c3n3/house_led_cube/solid_works/cube_assem.SLDASM

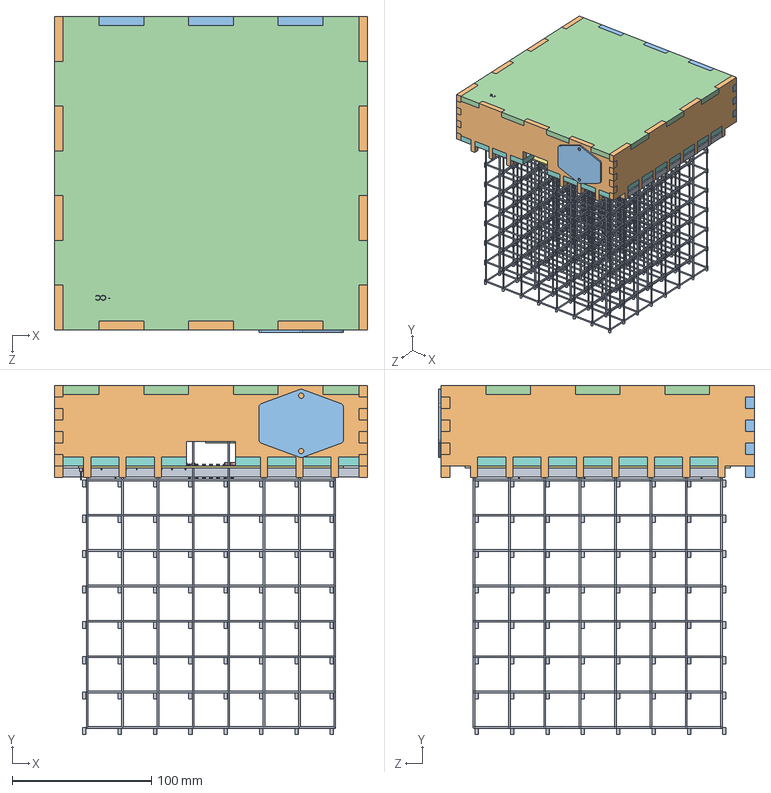
[picture p1: CAD file, 2020-12-22]
solid_works/cube_assem.SLDASM
225.0 x 250.6 x 226.9 mm
LED Cube
~side x 2
side_with_arduino
bottom
SOLID.step x 64
SOLID-0.step x 23
COMPOUND.step
holder x 2
cross_bar x 7
side
Switch
Power_Supply
