c3n3/house_led_cube/solid_works/bottom.SLDPRT

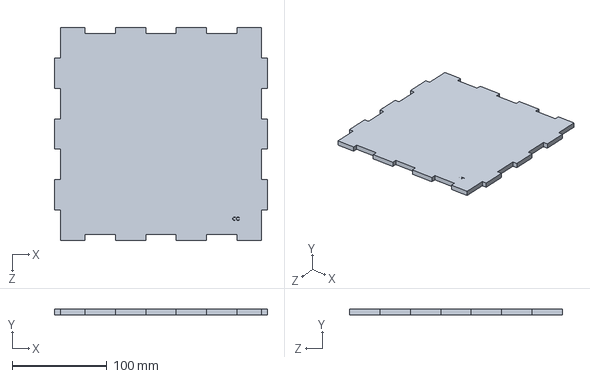
[picture p4: CAD file, 2020-12-22]
solid_works/bottom.SLDPRT
225.0 x 6.35 x 225.0 mm
