c3n3/house_led_cube/solid_works/holder.SLDPRT

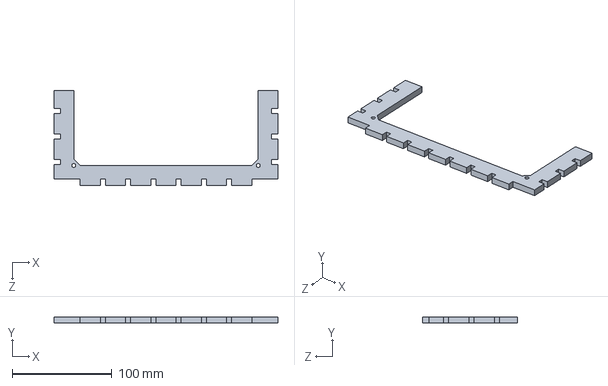
[picture p6: CAD file, 2020-12-22]
solid_works/holder.SLDPRT
225.0 x 6.35 x 95.0 mm
