c3n3/house_led_cube/solid_works/Switch.SLDPRT

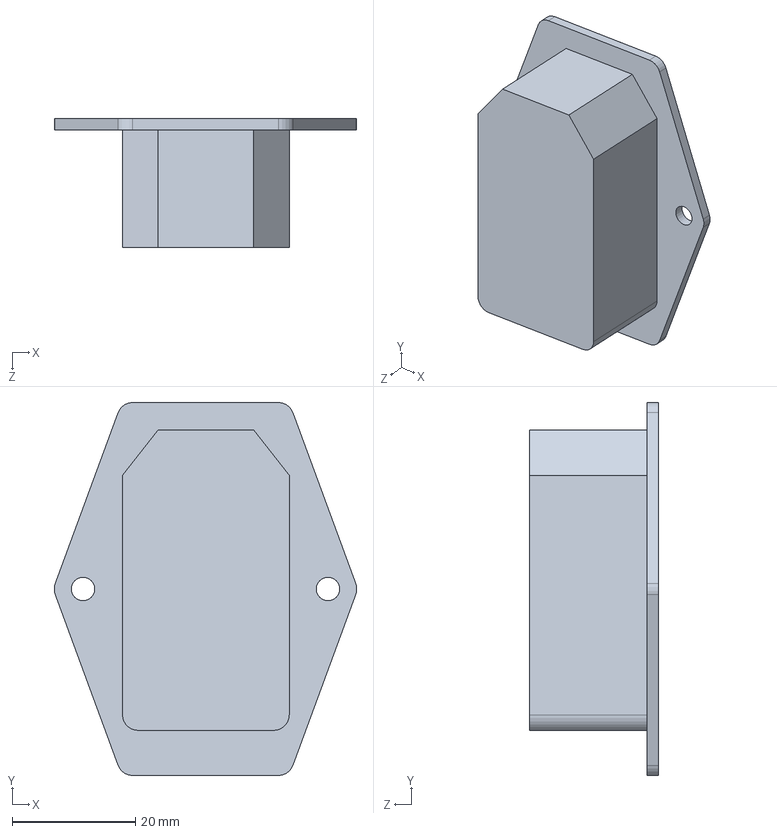
[picture p9: CAD file, 2020-12-22]
solid_works/Switch.SLDPRT
49.1 x 60.6 x 20.9 mm
