c3n3/house_led_cube/solid_works/laser_cube_base/bottom.DXF

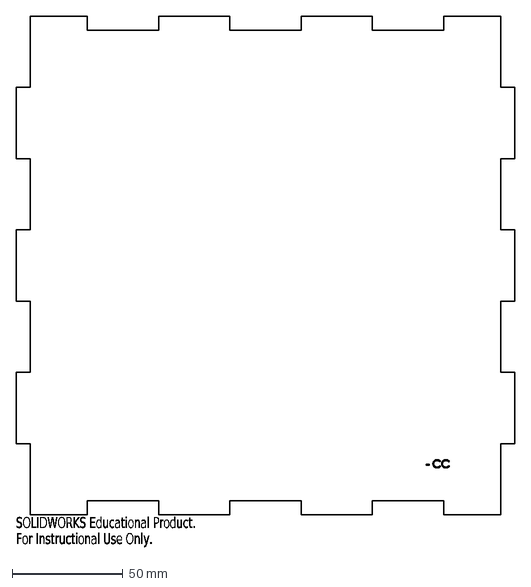
[picture p10: CAD file, 2020-12-22]
solid_works/laser_cube_base/bottom.DXF
SOLIDWORKS Educational Product.
For Instructional Use Only.
