c3n3/house_led_cube/solid_works/side_with_arduino.SLDPRT

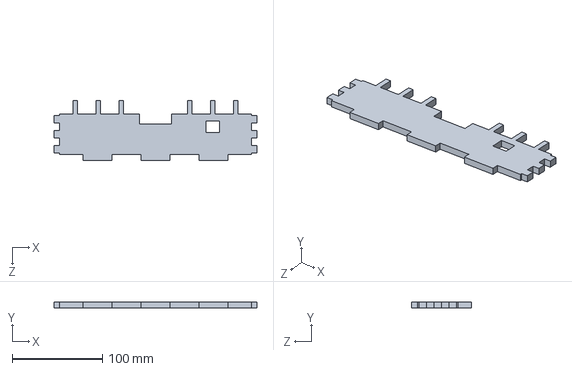
[picture p11: CAD file, 2020-12-22]
solid_works/side_with_arduino.SLDPRT
225.0 x 6.35 x 66.2 mm
