c3n3/house_led_cube/solid_works/led_cube_pcb.step

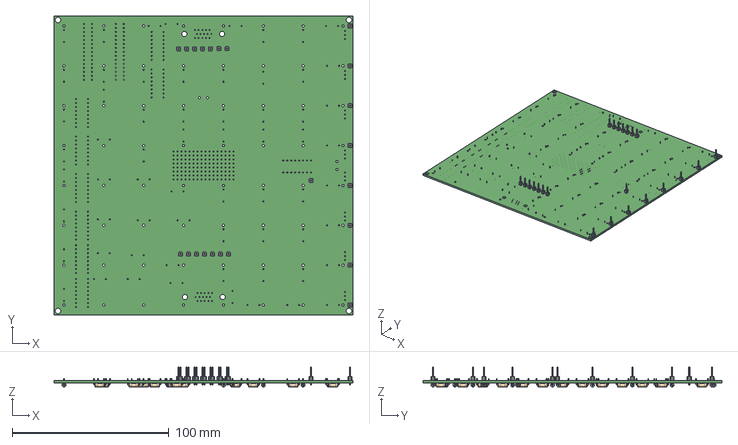
[picture p12: CAD file, 2020-12-08]
solid_works/led_cube_pcb.step
190.5 x 190.5 x 12.7 mm
