c3n3/house_led_cube/solid_works/cross_bar.SLDPRT

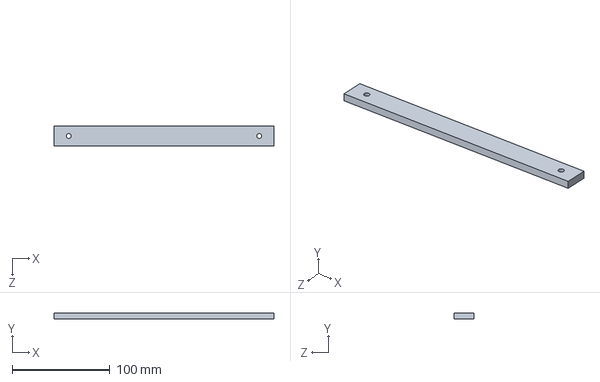
[picture p13: CAD file, 2020-12-08]
solid_works/cross_bar.SLDPRT
225.0 x 6.35 x 20.3 mm
