c3n3/house_led_cube/solid_works/pcb.SLDPRT

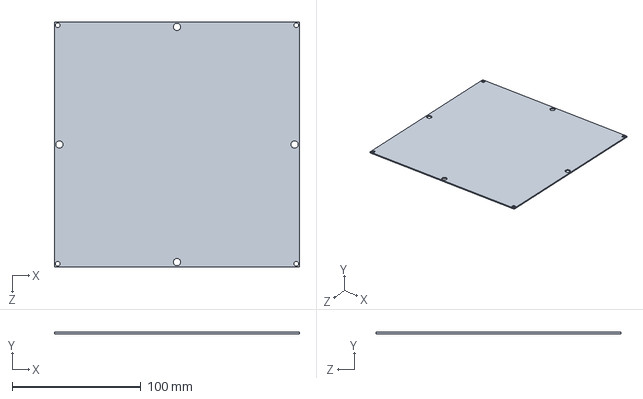
[picture p14: CAD file, 2020-12-03]
solid_works/pcb.SLDPRT
190.5 x 1.20 x 190.5 mm
