c3n3/house_led_cube/solid_works/led_array_4x8.SLDPRT

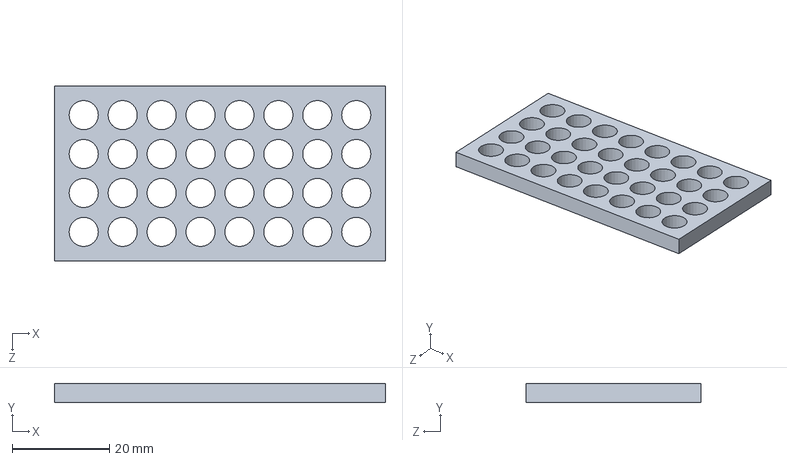
[picture p15: CAD file, 2020-09-20]
solid_works/led_array_4x8.SLDPRT
68.0 x 4.00 x 36.0 mm
