c3n3/house_led_cube/solid_works/Power_Supply.SLDPRT

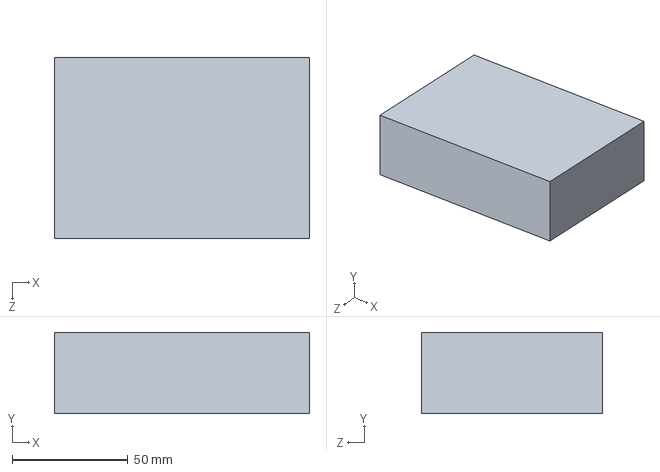
[picture p16: CAD file, 2020-09-08]
solid_works/Power_Supply.SLDPRT
110.0 x 35.0 x 78.0 mm
