c3n3/house_led_cube/solid_works/Base.SLDPRT

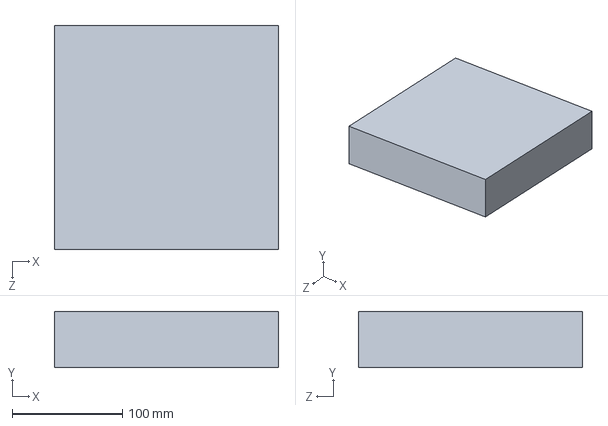
[picture p17: CAD file, 2020-09-08]
solid_works/Base.SLDPRT
203.2 x 50.8 x 203.2 mm
