c3n3/house_led_cube/(list of files, cad)

Other CAD files:
solid_works/box_temp.SLDPRT
solid_works/laser_cube_base/~side.DXF
solid_works/led_cube_pcb.SLDASM
solid_works/led_cube_pcb.SLDPRT
solid_works/~side.SLDPRT
