c3n3/house_led_cube/kicad/led_cube/controller/controller.kicad_pcb

## KiCad design kicad/led_cube/controller/controller.kicad_pcb (2020-12-22)

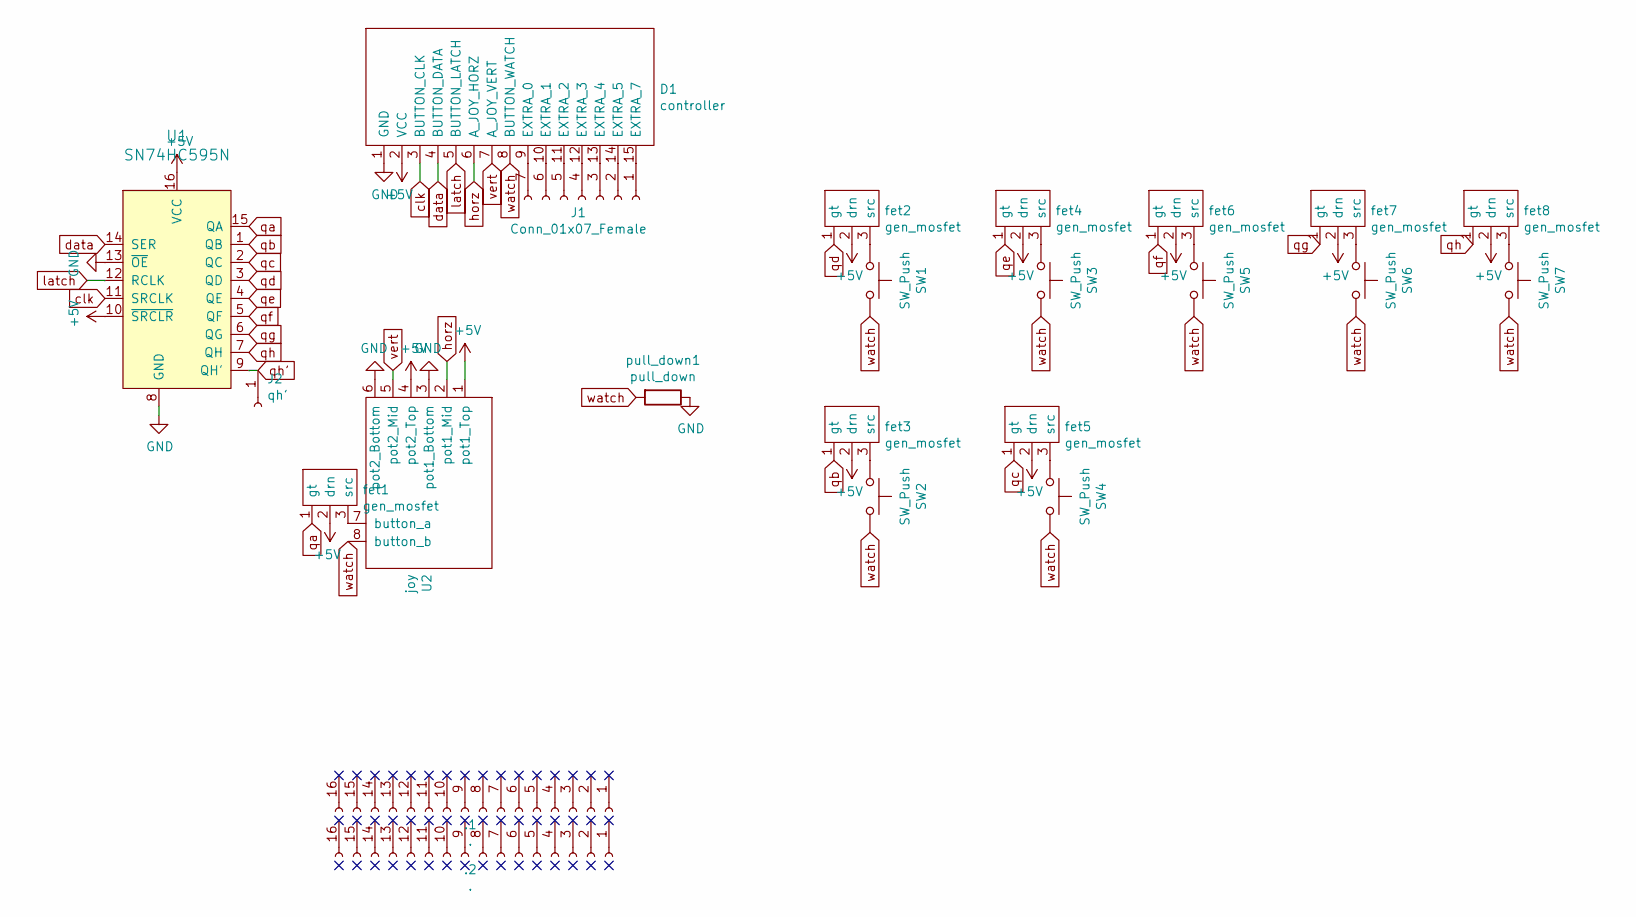
[picture p18: schematic controller.sch]

Parts:
.1, .2: .; proto
D1: controller; 15pin_controller
J1: Conn_01x07_Female; PinHeader_1x07_P2.54mm_Vertical
J2: qh'; PinHeader_1x01_P2.54mm_Horizontal
SW1, SW2, SW3, SW4, SW5, SW6, SW7: SW_Push; button
U1: SN74HC595N; MPN SN74HC595N; Digi-Key_PN 296-1600-5-ND
U2: joy
fet1, fet2, fet3, fet4, fet5, fet6, fet7, fet8: gen_mosfet; gen_fet
pull_down1: pull_down; R_Axial_DIN0207_L6.3mm_D2.5mm_P10.16mm_Horizontal

Connections:
+5V: D1.2 (VCC), U1.10 (~SRCLR), U1.16 (VCC), U2.1 (pot1_Top), U2.4 (pot2_Top), fet1.2 (drn), fet2.2 (drn), fet3.2 (drn), fet4.2 (drn), fet5.2 (drn), fet6.2 (drn), fet7.2 (drn), fet8.2 (drn)
GND: D1.1 (GND), U1.8 (GND), U1.13 (~OE), U2.3 (pot1_Bottom), U2.6 (pot2_Bottom), pull_down1.1
unnamed: D1.9 (EXTRA_0), J1.7
unnamed: D1.10 (EXTRA_1), J1.6
unnamed: D1.11 (EXTRA_2), J1.5
unnamed: D1.12 (EXTRA_3), J1.4
unnamed: D1.13 (EXTRA_4), J1.3
unnamed: D1.14 (EXTRA_5), J1.2
unnamed: D1.15 (EXTRA_7), J1.1
unnamed: SW1.1, fet2.3 (src)
unnamed: SW2.1, fet3.3 (src)
unnamed: SW3.1, fet4.3 (src)
unnamed: SW4.1, fet5.3 (src)
unnamed: SW5.1, fet6.3 (src)
unnamed: SW6.1, fet7.3 (src)
unnamed: SW7.1, fet8.3 (src)
unnamed: U2.7 (button_a), fet1.3 (src)
clk: D1.3 (BUTTON_CLK), U1.11 (SRCLK)
data: D1.4 (BUTTON_DATA), U1.14 (SER)
horz: D1.6 (A_JOY_HORZ), U2.2 (pot1_Mid)
latch: D1.5 (BUTTON_LATCH), U1.12 (RCLK)
qa: U1.15 (QA), fet1.1 (gt)
qb: U1.1 (QB), fet3.1 (gt)
qc: U1.2 (QC), fet5.1 (gt)
qd: U1.3 (QD), fet2.1 (gt)
qe: U1.4 (QE), fet4.1 (gt)
qf: U1.5 (QF), fet6.1 (gt)
qg: U1.6 (QG), fet7.1 (gt)
qh: U1.7 (QH), fet8.1 (gt)
qh': J2.1, U1.9 (QH')
vert: D1.7 (A_JOY_VERT), U2.5 (pot2_Mid)
watch: D1.8 (BUTTON_WATCH), SW1.2, SW2.2, SW3.2, SW4.2, SW5.2, SW6.2, SW7.2, U2.8 (button_b), pull_down1.2

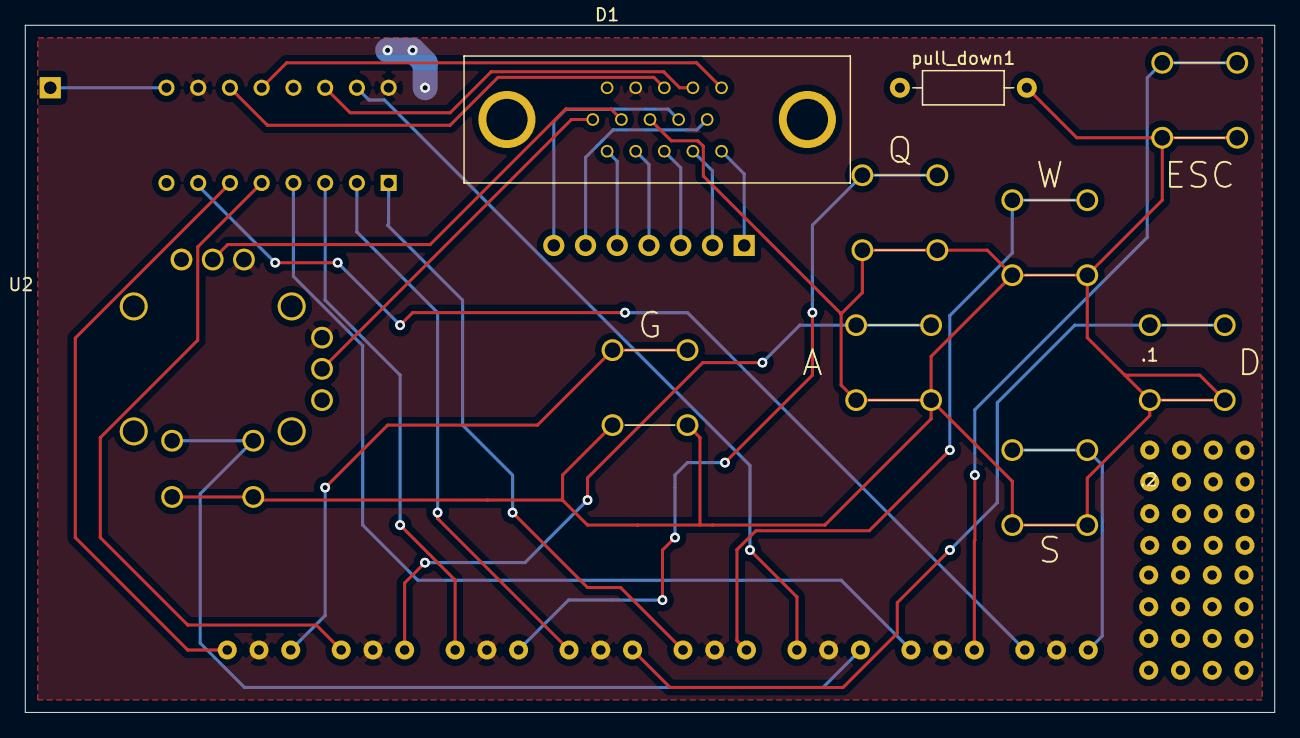
[picture p19: board controller.kicad_pcb from above]

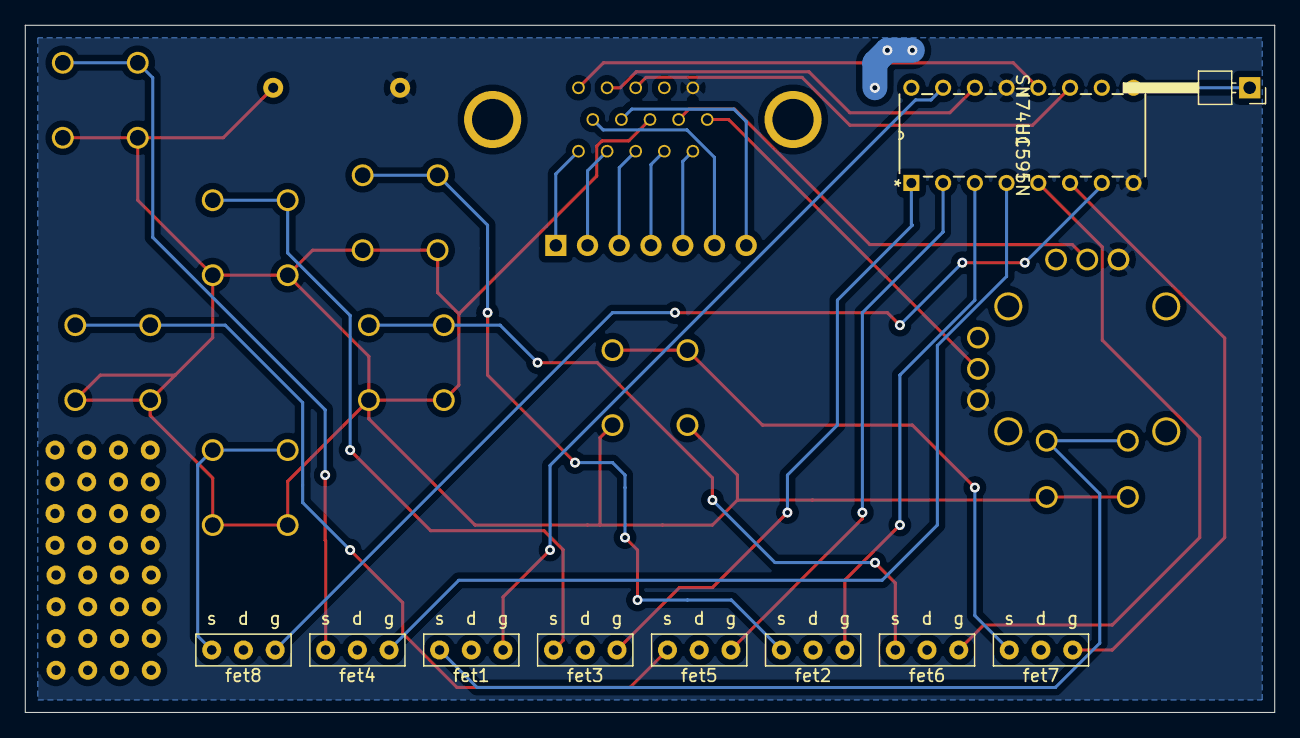
[picture p20: board controller.kicad_pcb from below]

Board: 2 copper layers, 100.0 x 55.0 mm, 23 parts (10 on the bottom side), 32 nets.
