c3n3/house_led_cube/kicad/led_cube/led_cube.kicad_pcb

## KiCad design kicad/led_cube/led_cube.kicad_pcb (2020-12-13)

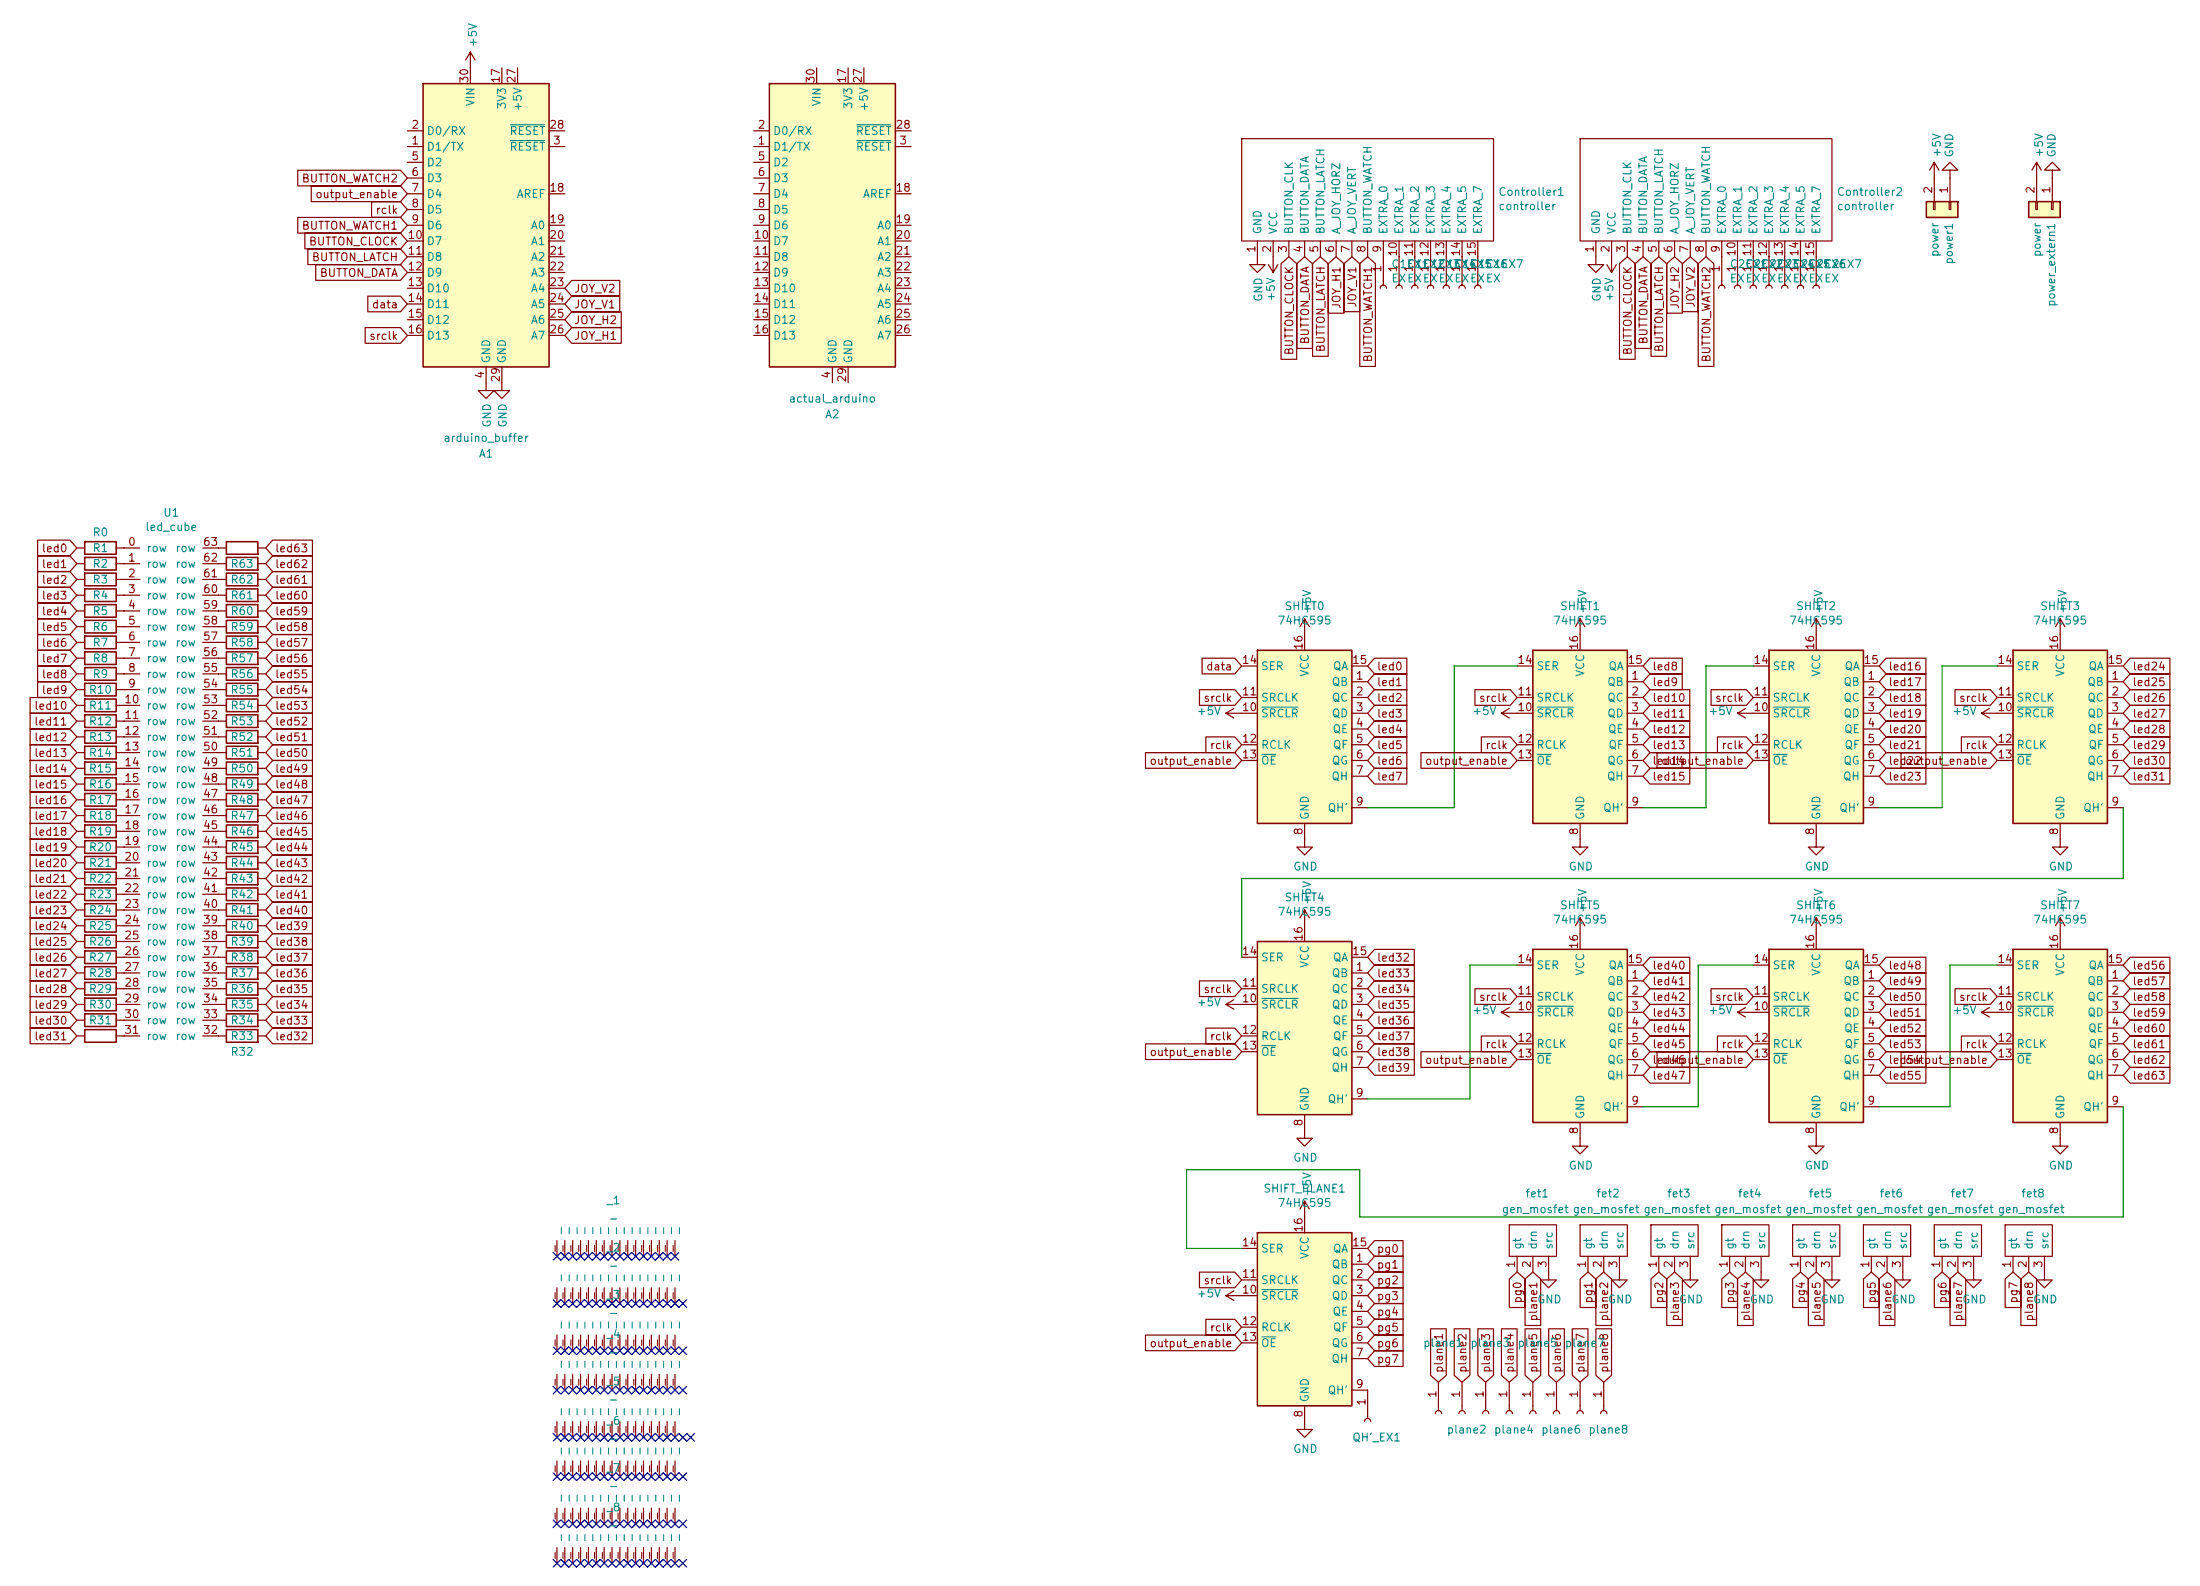
[picture p21: schematic led_cube.sch]

Parts:
A1: arduino_buffer; nano_buffer
A2: actual_arduino; nano
C1EX1, C1EX2, C1EX3, C1EX4, C1EX5, C1EX6, C1EX7, C2EX1, C2EX2, C2EX3, C2EX4, C2EX5, C2EX6, C2EX7: EX; PinHeader_1x01_P2.54mm_Vertical
Controller1, Controller2: controller; 15pin_controller
QH'_EX1: PinHeader_1x01_P2.54mm_Vertical
R0, R1, R2, R3, R4, R5, R6, R7, R8, R9, R10, R11, R12, R13, R14, R15, R16, R17, R18, R19, R20, R21, R22, R23, R24, R25, R26, R27, R28, R29, R30, R31, R32, R33, R34, R35, R36, R37, R38, R39, R40, R41, R42, R43, R44, R45, R46, R47, R48, R49, R50, R51, R52, R53, R54, R55, R56, R57, R58, R59, R60, R61, R62, R63: R_Axial_DIN0207_L6.3mm_D2.5mm_P7.62mm_Horizontal
SHIFT0, SHIFT1, SHIFT2, SHIFT3, SHIFT4, SHIFT5, SHIFT6, SHIFT7: 74HC595; SN74HC595N
SHIFT_PLANE1: 74HC595; SN74HC595N
U1: led_cube
_1, _2, _3, _4, _5, _6, _7, _8: _; proto
fet1, fet2, fet3, fet4, fet5, fet6, fet7, fet8: gen_mosfet; gen_fet
plane1, plane2, plane3, plane4, plane5, plane6, plane7, plane8: PinHeader_1x01_P2.54mm_Vertical
power1: power
power_extern1: power

Connections:
+5V: A1.30 (VIN), Controller1.2 (VCC), Controller2.2 (VCC), SHIFT0.10 (~SRCLR), SHIFT0.16 (VCC), SHIFT1.10 (~SRCLR), SHIFT1.16 (VCC), SHIFT2.10 (~SRCLR), SHIFT2.16 (VCC), SHIFT3.10 (~SRCLR), SHIFT3.16 (VCC), SHIFT4.10 (~SRCLR), SHIFT4.16 (VCC), SHIFT5.10 (~SRCLR), SHIFT5.16 (VCC), SHIFT6.10 (~SRCLR), SHIFT6.16 (VCC), SHIFT7.10 (~SRCLR), SHIFT7.16 (VCC), SHIFT_PLANE1.10 (~SRCLR), SHIFT_PLANE1.16 (VCC), power1.2, power_extern1.2
BUTTON_CLOCK: A1.10 (D7), Controller1.3 (BUTTON_CLK), Controller2.3 (BUTTON_CLK)
BUTTON_DATA: A1.12 (D9), Controller1.4 (BUTTON_DATA), Controller2.4 (BUTTON_DATA)
BUTTON_LATCH: A1.11 (D8), Controller1.5 (BUTTON_LATCH), Controller2.5 (BUTTON_LATCH)
BUTTON_WATCH1: A1.9 (D6), Controller1.8 (BUTTON_WATCH)
BUTTON_WATCH2: A1.6 (D3), Controller2.8 (BUTTON_WATCH)
GND: A1.4 (GND), A1.29 (GND), Controller1.1 (GND), Controller2.1 (GND), SHIFT0.8 (GND), SHIFT1.8 (GND), SHIFT2.8 (GND), SHIFT3.8 (GND), SHIFT4.8 (GND), SHIFT5.8 (GND), SHIFT6.8 (GND), SHIFT7.8 (GND), SHIFT_PLANE1.8 (GND), fet1.3 (src), fet2.3 (src), fet3.3 (src), fet4.3 (src), fet5.3 (src), fet6.3 (src), fet7.3 (src), fet8.3 (src), power1.1, power_extern1.1
JOY_H1: A1.26 (A7), Controller1.6 (A_JOY_HORZ)
JOY_H2: A1.25 (A6), Controller2.6 (A_JOY_HORZ)
JOY_V1: A1.24 (A5), Controller1.7 (A_JOY_VERT)
JOY_V2: A1.23 (A4), Controller2.7 (A_JOY_VERT)
unnamed: C1EX1.1, Controller1.9 (EXTRA_0)
unnamed: C1EX2.1, Controller1.10 (EXTRA_1)
unnamed: C1EX3.1, Controller1.11 (EXTRA_2)
unnamed: C1EX4.1, Controller1.12 (EXTRA_3)
unnamed: C1EX5.1, Controller1.13 (EXTRA_4)
unnamed: C1EX6.1, Controller1.14 (EXTRA_5)
unnamed: C1EX7.1, Controller1.15 (EXTRA_7)
unnamed: C2EX1.1, Controller2.9 (EXTRA_0)
unnamed: C2EX2.1, Controller2.10 (EXTRA_1)
unnamed: C2EX3.1, Controller2.11 (EXTRA_2)
unnamed: C2EX4.1, Controller2.12 (EXTRA_3)
unnamed: C2EX5.1, Controller2.13 (EXTRA_4)
unnamed: C2EX6.1, Controller2.14 (EXTRA_5)
unnamed: C2EX7.1, Controller2.15 (EXTRA_7)
unnamed: QH'_EX1.1, SHIFT_PLANE1.9 (QH')
unnamed: R0.1, U1.0
unnamed: R1.1, U1.1
unnamed: R2.1, U1.2
unnamed: R3.1, U1.3
unnamed: R4.1, U1.4
unnamed: R5.1, U1.5
unnamed: R6.1, U1.6
unnamed: R7.1, U1.7
unnamed: R8.1, U1.8
unnamed: R9.1, U1.9
unnamed: R10.1, U1.10
unnamed: R11.1, U1.11
unnamed: R12.1, U1.12
unnamed: R13.1, U1.13
unnamed: R14.1, U1.14
unnamed: R15.1, U1.15
unnamed: R16.1, U1.16
unnamed: R17.1, U1.17
unnamed: R18.1, U1.18
unnamed: R19.1, U1.19
unnamed: R20.1, U1.20
unnamed: R21.1, U1.21
unnamed: R22.1, U1.22
unnamed: R23.1, U1.23
unnamed: R24.1, U1.24
unnamed: R25.1, U1.25
unnamed: R26.1, U1.26
unnamed: R27.1, U1.27
unnamed: R28.1, U1.28
unnamed: R29.1, U1.29
unnamed: R30.1, U1.30
unnamed: R31.1, U1.31
unnamed: R32.1, U1.32
unnamed: R33.1, U1.33
unnamed: R34.1, U1.34
unnamed: R35.1, U1.35
unnamed: R36.1, U1.36
unnamed: R37.1, U1.37
unnamed: R38.1, U1.38
unnamed: R39.1, U1.39
unnamed: R40.1, U1.40
unnamed: R41.1, U1.41
unnamed: R42.1, U1.42
unnamed: R43.1, U1.43
unnamed: R44.1, U1.44
unnamed: R45.1, U1.45
unnamed: R46.1, U1.46
unnamed: R47.1, U1.47
unnamed: R48.1, U1.48
unnamed: R49.1, U1.49
unnamed: R50.1, U1.50
unnamed: R51.1, U1.51
unnamed: R52.1, U1.52
unnamed: R53.1, U1.53
unnamed: R54.1, U1.54
unnamed: R55.1, U1.55
unnamed: R56.1, U1.56
unnamed: R57.1, U1.57
unnamed: R58.1, U1.58
unnamed: R59.1, U1.59
unnamed: R60.1, U1.60
unnamed: R61.1, U1.61
unnamed: R62.1, U1.62
unnamed: R63.1, U1.63
unnamed: SHIFT0.9 (QH'), SHIFT1.14 (SER)
unnamed: SHIFT1.9 (QH'), SHIFT2.14 (SER)
unnamed: SHIFT2.9 (QH'), SHIFT3.14 (SER)
unnamed: SHIFT3.9 (QH'), SHIFT4.14 (SER)
unnamed: SHIFT4.9 (QH'), SHIFT5.14 (SER)
unnamed: SHIFT5.9 (QH'), SHIFT6.14 (SER)
unnamed: SHIFT6.9 (QH'), SHIFT7.14 (SER)
unnamed: SHIFT7.9 (QH'), SHIFT_PLANE1.14 (SER)
data: A1.14 (D11), SHIFT0.14 (SER)
led0: R0.2, SHIFT0.15 (QA)
led1: R1.2, SHIFT0.1 (QB)
led2: R2.2, SHIFT0.2 (QC)
led3: R3.2, SHIFT0.3 (QD)
led4: R4.2, SHIFT0.4 (QE)
led5: R5.2, SHIFT0.5 (QF)
led6: R6.2, SHIFT0.6 (QG)
led7: R7.2, SHIFT0.7 (QH)
led8: R8.2, SHIFT1.15 (QA)
led9: R9.2, SHIFT1.1 (QB)
led10: R10.2, SHIFT1.2 (QC)
led11: R11.2, SHIFT1.3 (QD)
led12: R12.2, SHIFT1.4 (QE)
led13: R13.2, SHIFT1.5 (QF)
led14: R14.2, SHIFT1.6 (QG)
led15: R15.2, SHIFT1.7 (QH)
led16: R16.2, SHIFT2.15 (QA)
led17: R17.2, SHIFT2.1 (QB)
led18: R18.2, SHIFT2.2 (QC)
led19: R19.2, SHIFT2.3 (QD)
led20: R20.2, SHIFT2.4 (QE)
led21: R21.2, SHIFT2.5 (QF)
led22: R22.2, SHIFT2.6 (QG)
led23: R23.2, SHIFT2.7 (QH)
led24: R24.2, SHIFT3.15 (QA)
led25: R25.2, SHIFT3.1 (QB)
led26: R26.2, SHIFT3.2 (QC)
led27: R27.2, SHIFT3.3 (QD)
led28: R28.2, SHIFT3.4 (QE)
led29: R29.2, SHIFT3.5 (QF)
led30: R30.2, SHIFT3.6 (QG)
led31: R31.2, SHIFT3.7 (QH)
led32: R32.2, SHIFT4.15 (QA)
led33: R33.2, SHIFT4.1 (QB)
led34: R34.2, SHIFT4.2 (QC)
led35: R35.2, SHIFT4.3 (QD)
led36: R36.2, SHIFT4.4 (QE)
led37: R37.2, SHIFT4.5 (QF)
led38: R38.2, SHIFT4.6 (QG)
led39: R39.2, SHIFT4.7 (QH)
led40: R40.2, SHIFT5.15 (QA)
led41: R41.2, SHIFT5.1 (QB)
led42: R42.2, SHIFT5.2 (QC)
led43: R43.2, SHIFT5.3 (QD)
led44: R44.2, SHIFT5.4 (QE)
led45: R45.2, SHIFT5.5 (QF)
led46: R46.2, SHIFT5.6 (QG)
led47: R47.2, SHIFT5.7 (QH)
led48: R48.2, SHIFT6.15 (QA)
led49: R49.2, SHIFT6.1 (QB)
led50: R50.2, SHIFT6.2 (QC)
led51: R51.2, SHIFT6.3 (QD)
led52: R52.2, SHIFT6.4 (QE)
led53: R53.2, SHIFT6.5 (QF)
led54: R54.2, SHIFT6.6 (QG)
led55: R55.2, SHIFT6.7 (QH)
led56: R56.2, SHIFT7.15 (QA)
led57: R57.2, SHIFT7.1 (QB)
led58: R58.2, SHIFT7.2 (QC)
led59: R59.2, SHIFT7.3 (QD)
led60: R60.2, SHIFT7.4 (QE)
led61: R61.2, SHIFT7.5 (QF)
led62: R62.2, SHIFT7.6 (QG)
led63: R63.2, SHIFT7.7 (QH)
output_enable: A1.7 (D4), SHIFT0.13 (~OE), SHIFT1.13 (~OE), SHIFT2.13 (~OE), SHIFT3.13 (~OE), SHIFT4.13 (~OE), SHIFT5.13 (~OE), SHIFT6.13 (~OE), SHIFT7.13 (~OE), SHIFT_PLANE1.13 (~OE)
pg0: SHIFT_PLANE1.15 (QA), fet1.1 (gt)
pg1: SHIFT_PLANE1.1 (QB), fet2.1 (gt)
pg2: SHIFT_PLANE1.2 (QC), fet3.1 (gt)
pg3: SHIFT_PLANE1.3 (QD), fet4.1 (gt)
pg4: SHIFT_PLANE1.4 (QE), fet5.1 (gt)
pg5: SHIFT_PLANE1.5 (QF), fet6.1 (gt)
pg6: SHIFT_PLANE1.6 (QG), fet7.1 (gt)
pg7: SHIFT_PLANE1.7 (QH), fet8.1 (gt)
plane1: fet1.2 (drn), plane1.1
plane2: fet2.2 (drn), plane2.1
plane3: fet3.2 (drn), plane3.1
plane4: fet4.2 (drn), plane4.1
plane5: fet5.2 (drn), plane5.1
plane6: fet6.2 (drn), plane6.1
plane7: fet7.2 (drn), plane7.1
plane8: fet8.2 (drn), plane8.1
rclk: A1.8 (D5), SHIFT0.12 (RCLK), SHIFT1.12 (RCLK), SHIFT2.12 (RCLK), SHIFT3.12 (RCLK), SHIFT4.12 (RCLK), SHIFT5.12 (RCLK), SHIFT6.12 (RCLK), SHIFT7.12 (RCLK), SHIFT_PLANE1.12 (RCLK)
srclk: A1.16 (D13), SHIFT0.11 (SRCLK), SHIFT1.11 (SRCLK), SHIFT2.11 (SRCLK), SHIFT3.11 (SRCLK), SHIFT4.11 (SRCLK), SHIFT5.11 (SRCLK), SHIFT6.11 (SRCLK), SHIFT7.11 (SRCLK), SHIFT_PLANE1.11 (SRCLK)

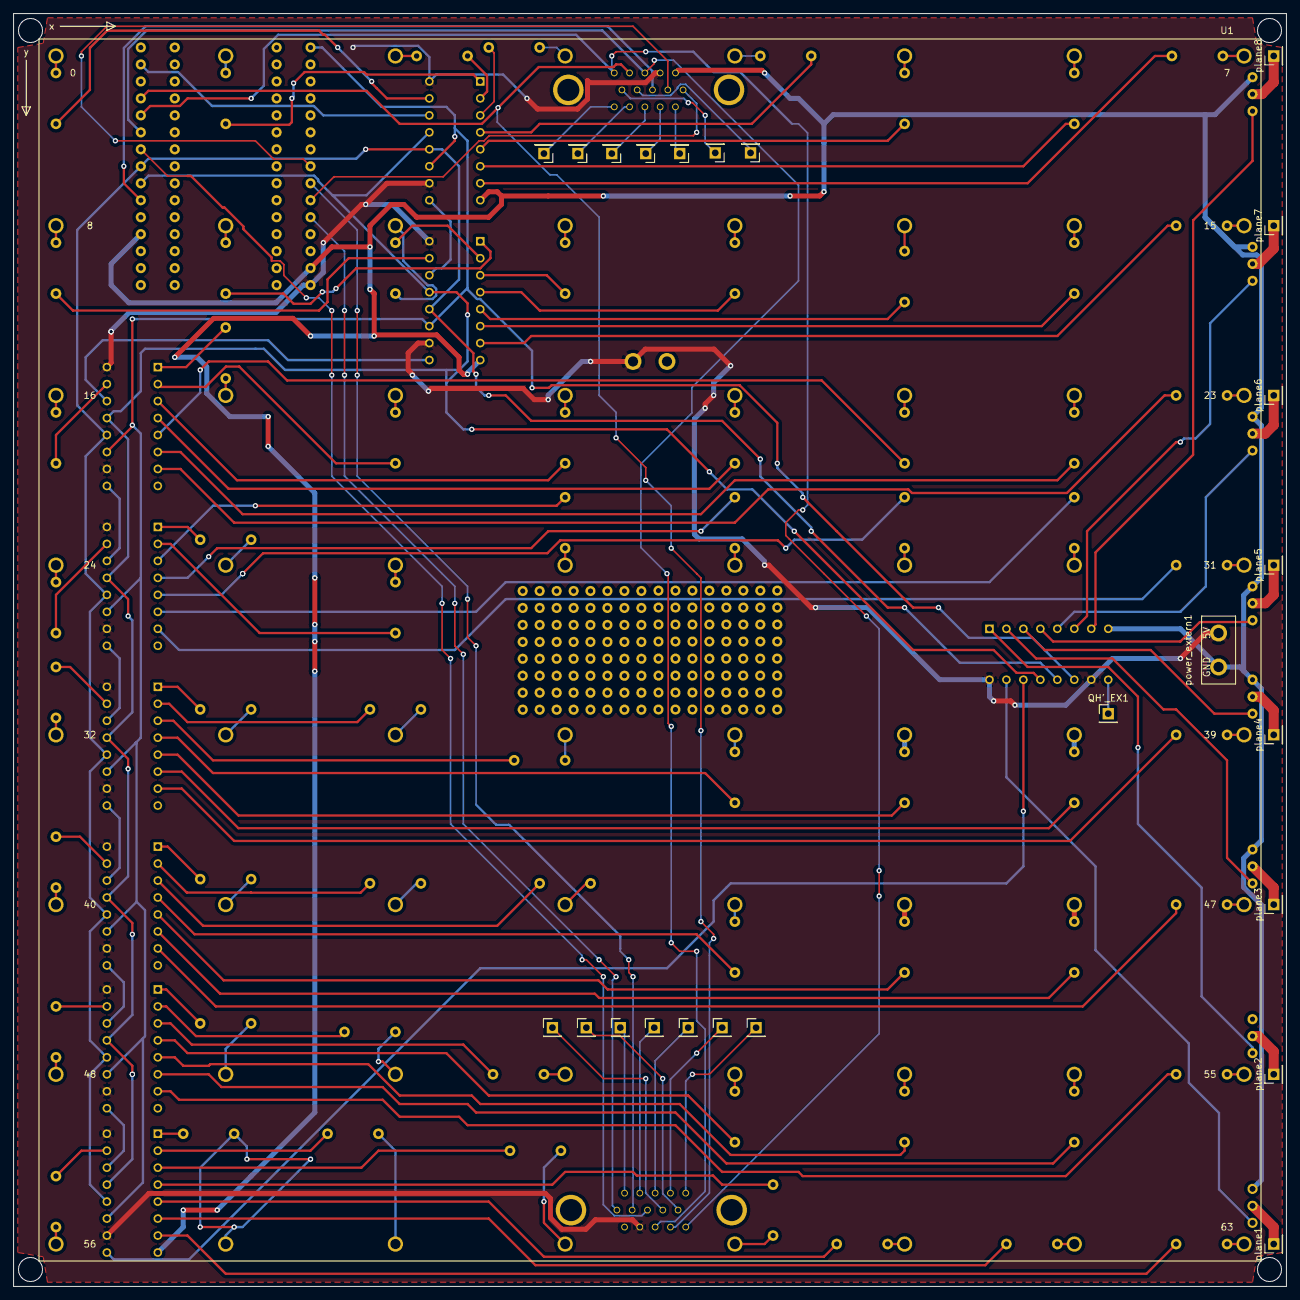
[picture p22: board led_cube.kicad_pcb from above]

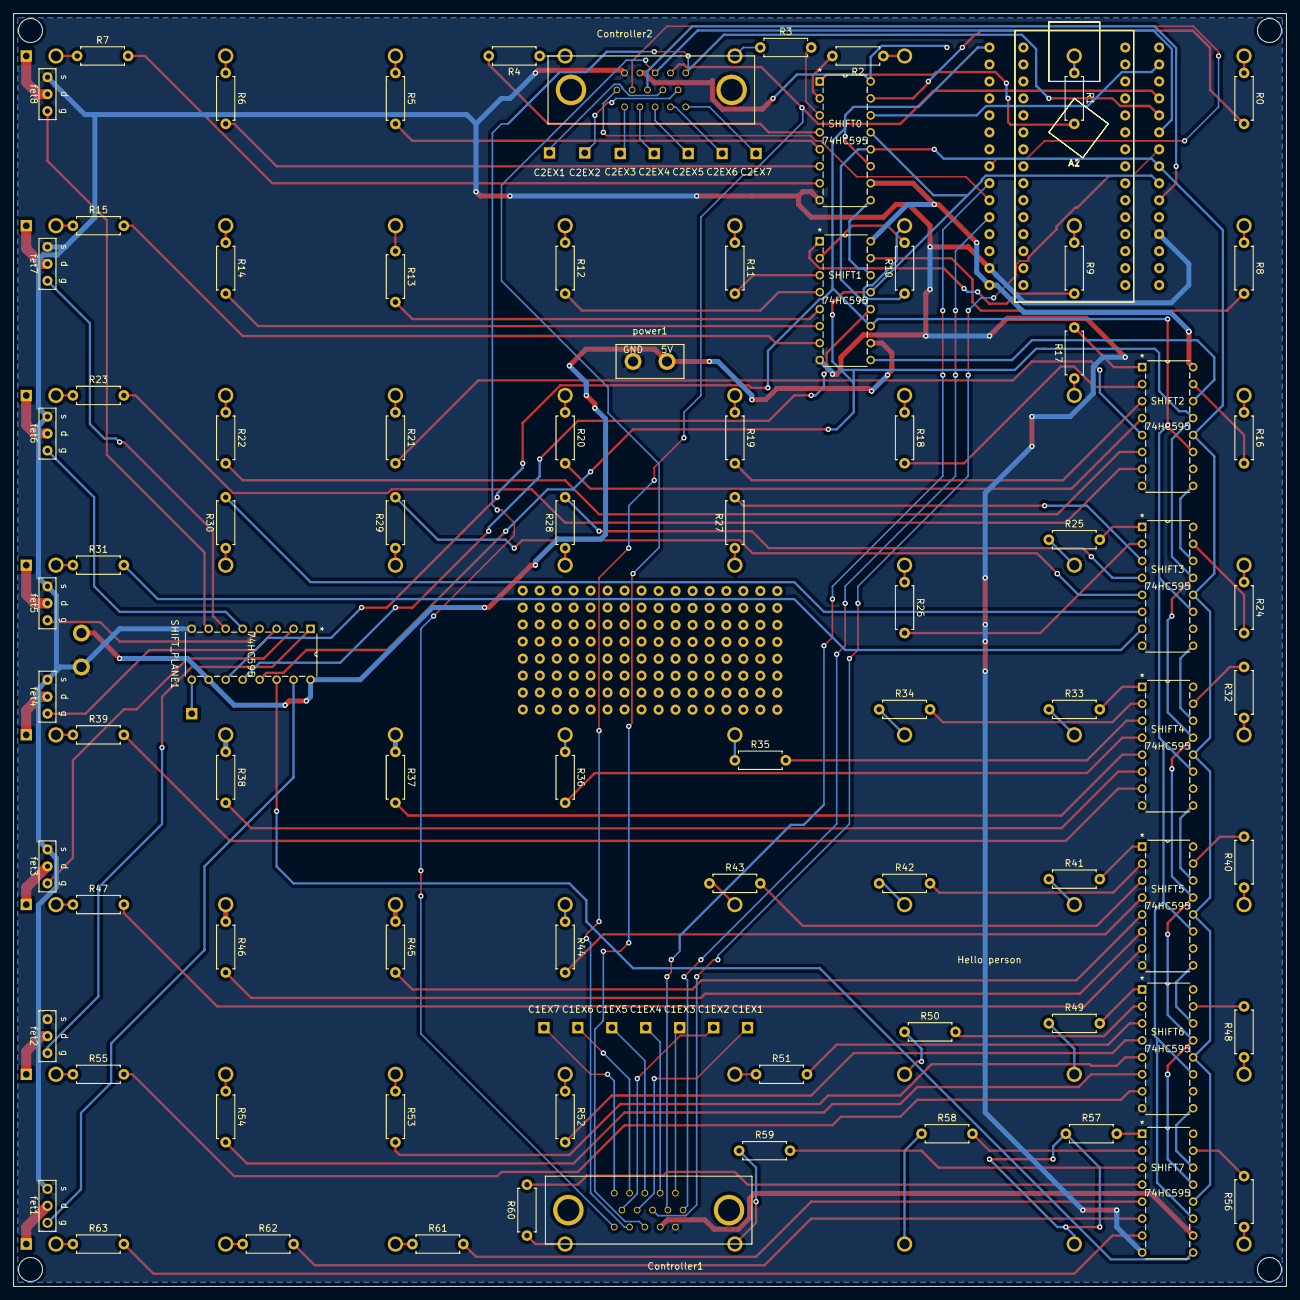
[picture p23: board led_cube.kicad_pcb from below]

Board: 2 copper layers, 190.5 x 190.5 mm, 119 parts (86 on the bottom side), 182 nets.
