c3n3/house_led_cube/kicad/Controller Board/ControllerBoard/ControllerBoard.kicad_pcb

## KiCad design kicad/Controller Board/ControllerBoard/ControllerBoard.kicad_pcb (2020-09-08)

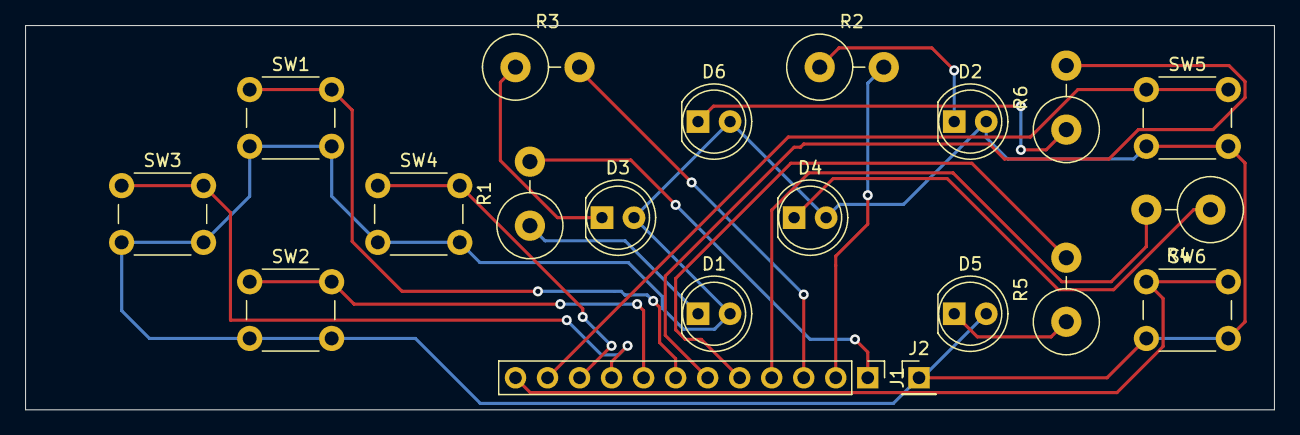
[picture p24: board ControllerBoard.kicad_pcb from above]

Board: 2 copper layers, 99.1 x 30.5 mm, 20 parts (0 on the bottom side), 19 nets.

Parts:
D1, D2, D3, D4, D5, D6: LED; LED_D5.0mm
J1: Conn_01x12_Male; PinHeader_1x12_P2.54mm_Vertical
J2: Conn_01x01_Male; PinHeader_1x01_P2.54mm_Vertical
R1, R2, R3, R4, R5, R6: R; R_Axial_DIN0516_L15.5mm_D5.0mm_P5.08mm_Vertical
SW1: Up; SW_PUSH_6mm_H5mm
SW2: Down; SW_PUSH_6mm_H5mm
SW3: Left; SW_PUSH_6mm_H5mm
SW4: Right; SW_PUSH_6mm_H5mm
SW5: Forward; SW_PUSH_6mm_H5mm
SW6: Backwards; SW_PUSH_6mm_H5mm

Connections:
Backwards: J1.12, SW6.1
Down: J1.8, SW2.1
Froward: J1.11, SW5.1
GND: D1.2, D2.2, D3.2, D4.2, D5.2, D6.2, J2.1, SW1.2, SW2.2, SW3.2, SW4.2, SW5.2, SW6.2
LED1: J1.1, R1.2
LED2: J1.2, R2.2
LED3: J1.3, R3.2
LED4: J1.4, R4.2
LED5: J1.5, R5.2
LED6: J1.6, R6.2
Left: J1.9, SW3.1
unnamed: D1.1, R1.1
unnamed: D2.1, R2.1
unnamed: D3.1, R3.1
unnamed: D4.1, R4.1
unnamed: D5.1, R5.1
unnamed: D6.1, R6.1
Right: J1.10, SW4.1
Up: J1.7, SW1.1
