c3n3/house_led_cube/(commit log)

2020-09-06 Added solid works starter
    [led_cube_pcb.SLDPRT]
2020-09-06 Added kicad files folder
    [led_cube.kicad_pcb, led_cube.sch]
2020-09-08 Controller for 3D snake
    [ControllerBoard.kicad_pcb, ControllerBoard.sch]
2020-09-08 Solidworks LED Cube
    [Base.SLDPRT, Power_Supply.SLDPRT]
2020-09-11 Solid works switch
    [Switch.SLDPRT]
2020-09-13 The led cube kicad is growing
2020-09-20 Added code and new 8x4 array in solid works
    [led_array_4x8.SLDPRT]
2020-12-03 Added stuff
    [pcb.SLDPRT]
2020-12-08 Added lots of stuff
    [bottom.SLDPRT, box_temp.SLDPRT, box_template.SLDPRT, cross_bar.SLDPRT, cube_assem.SLDASM, holder.SLDPRT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]
2020-12-13 Added lots
    [led_cube.kicad_pcb]
2021-01-01 SAMD boards now work flawlessly
